EzraRC/CSC4640-Project1/(commit log)

2023-09-26 Create Project_1_Temperature_Scanner.ino
    Code for the Arduino Uno Rev3 to work correctly with the sensor and OLED screen.
    [Project_1_Temperature_Scanner.ino]
2023-09-26 Fixing text output on OLED
    [Project_1_Temperature_Scanner.ino]
2023-09-28 Update README.md with the schematic and description
2023-09-28 Calibrated sensor to be more accurate
2023-09-28 Further calibrate the AHT20 readings
